davidrothb/ebar/docs/20211007_023445.jpg

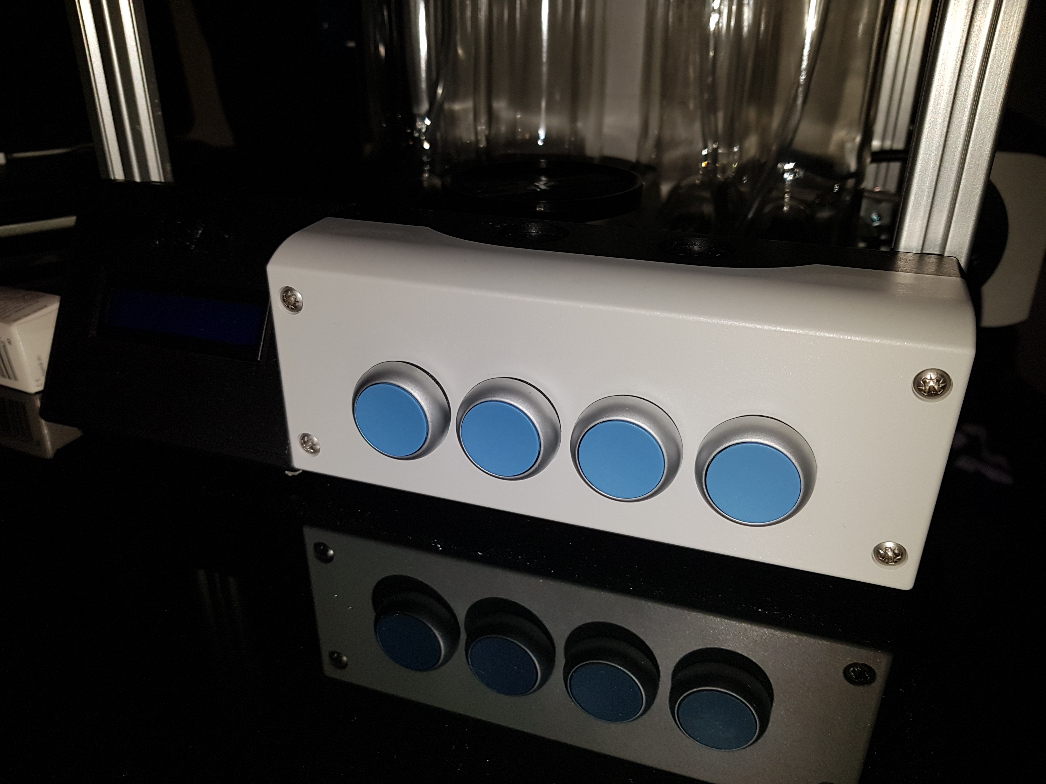
docs/20211007_023445.jpg
