davidrothb/ebar/docs/20210610_223108.jpg

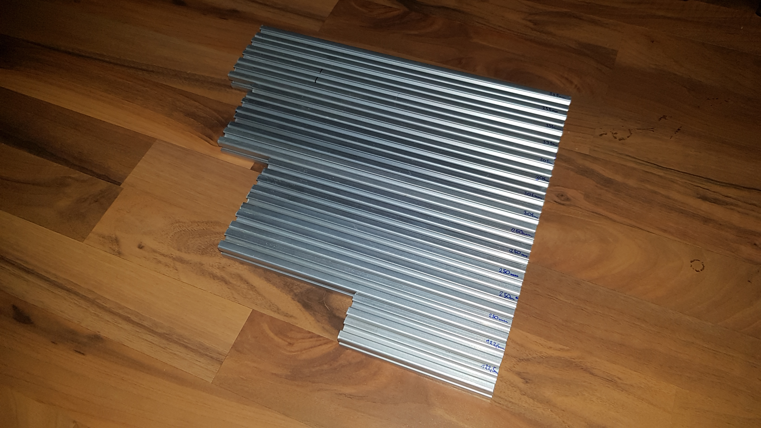
docs/20210610_223108.jpg
