davidrothb/ebar/docs/20210904_211101.jpg

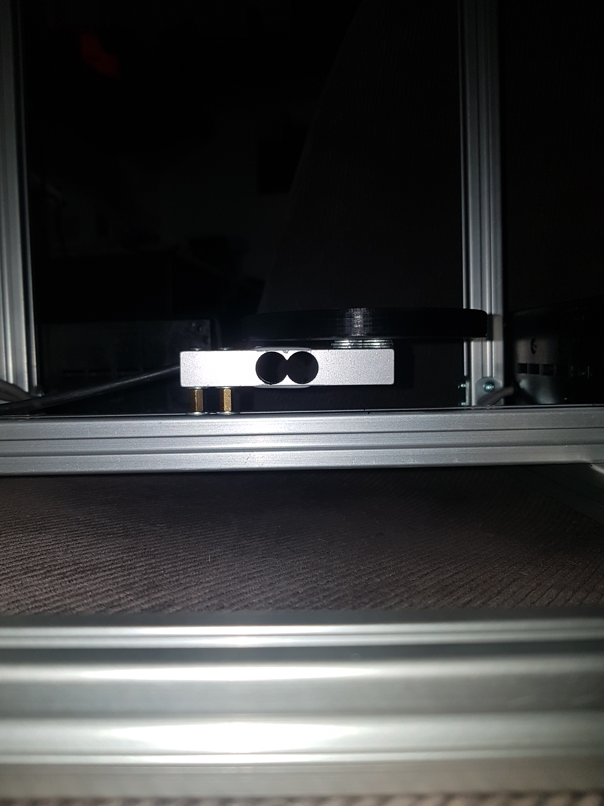
docs/20210904_211101.jpg
