davidrothb/ebar/docs/20210916_174710.jpg

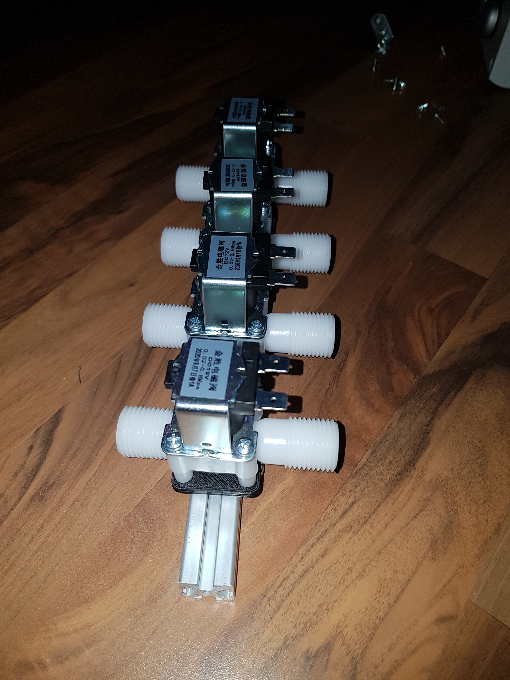
docs/20210916_174710.jpg
