davidrothb/ebar/docs/20210920_230038.jpg

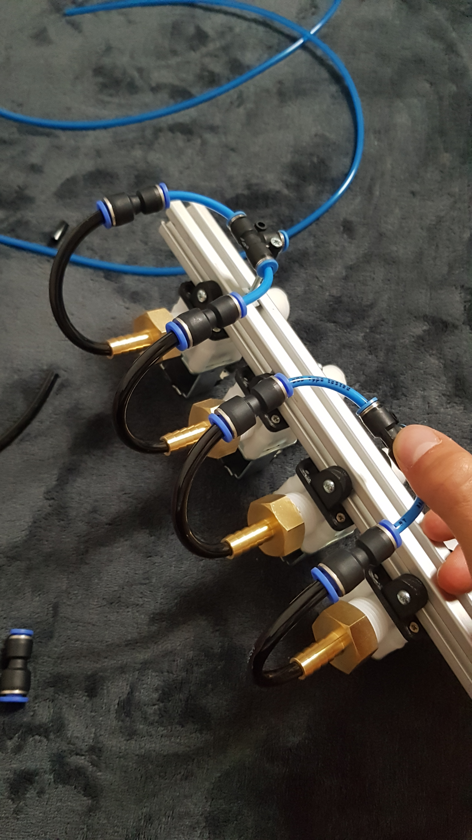
docs/20210920_230038.jpg
