davidrothb/ebar/docs/20210921_202324.jpg

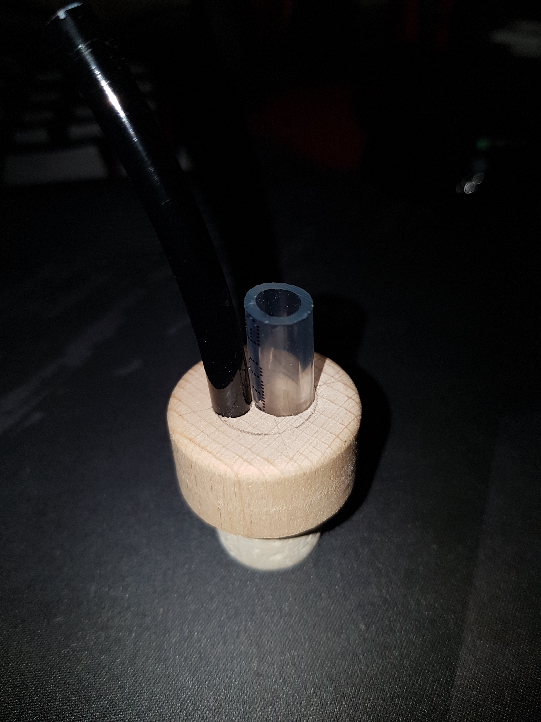
docs/20210921_202324.jpg
