davidrothb/ebar/docs/20210921_202337.jpg

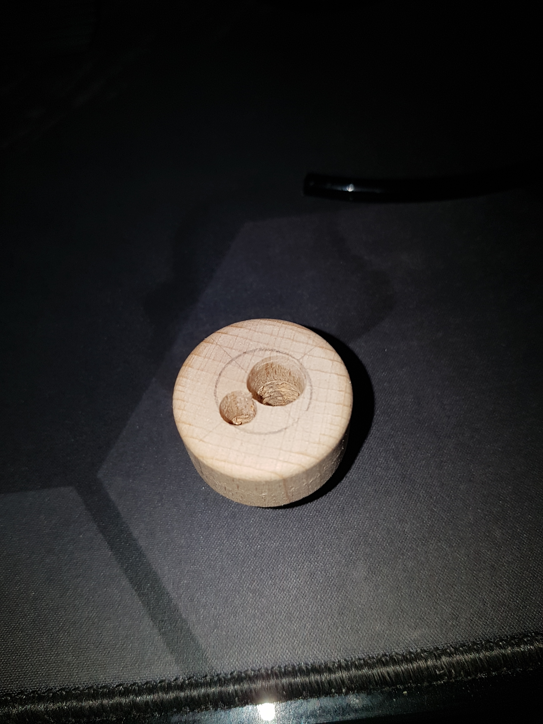
docs/20210921_202337.jpg
