davidrothb/ebar/docs/20210921_204439.jpg

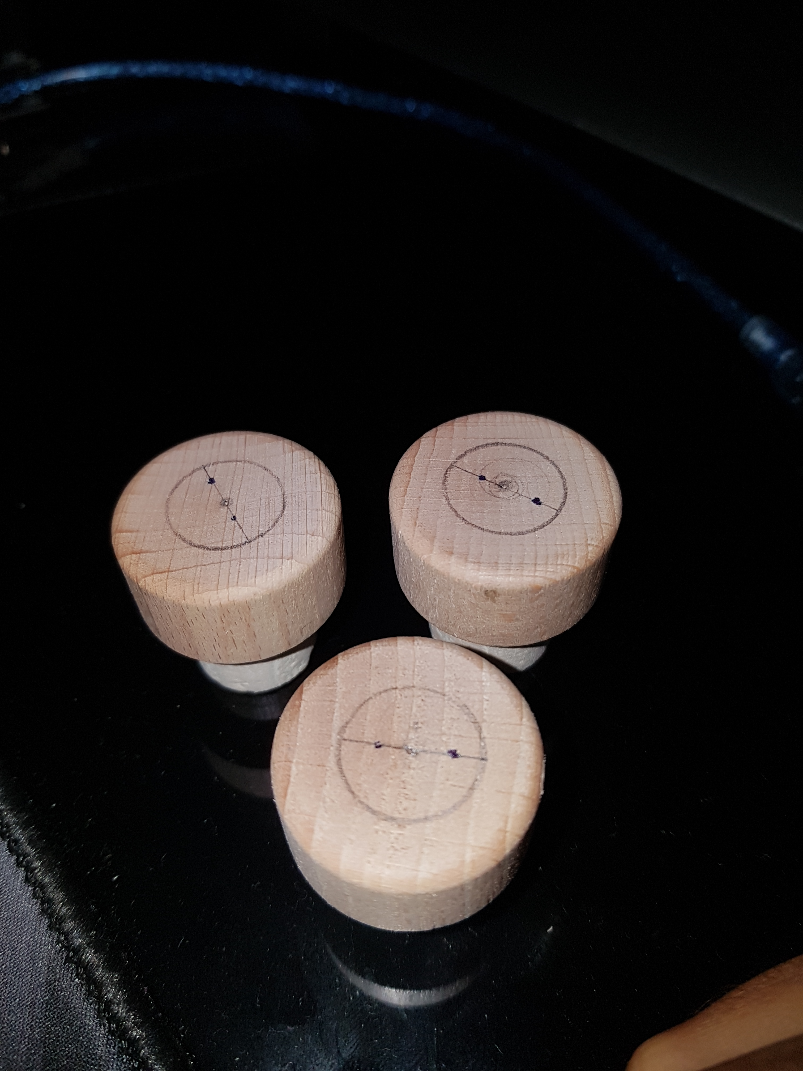
docs/20210921_204439.jpg
