davidrothb/ebar/docs/20210922_183712.jpg

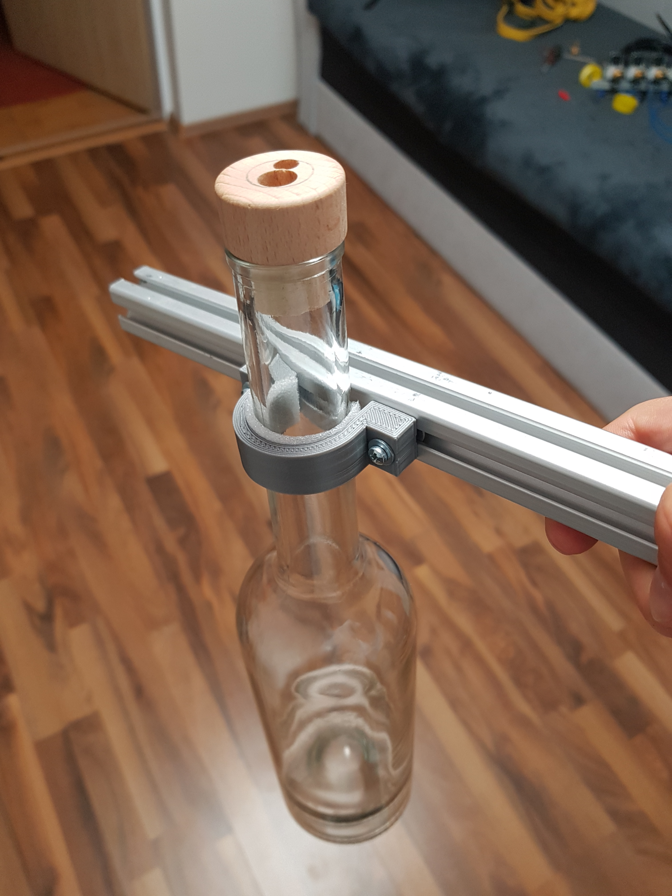
docs/20210922_183712.jpg
