davidrothb/ebar/docs/20210925_224214.jpg

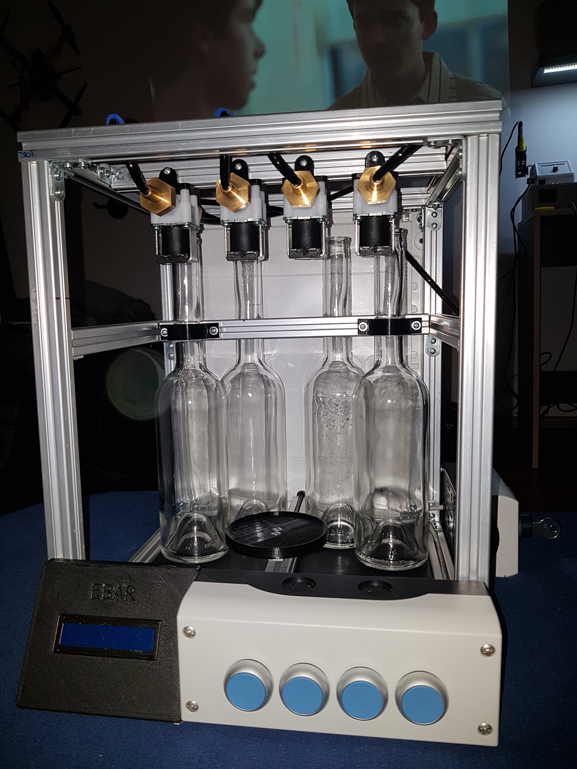
docs/20210925_224214.jpg
