davidrothb/ebar/docs/20210926_215040.jpg

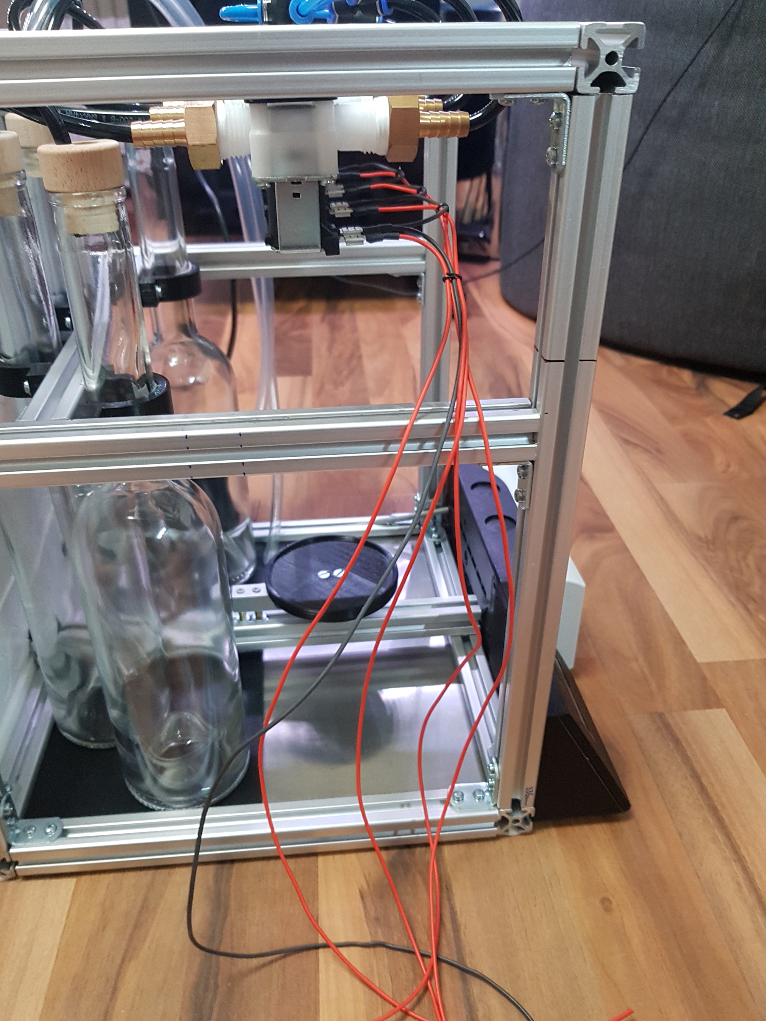
docs/20210926_215040.jpg
