davidrothb/ebar/docs/20210926_222534.jpg

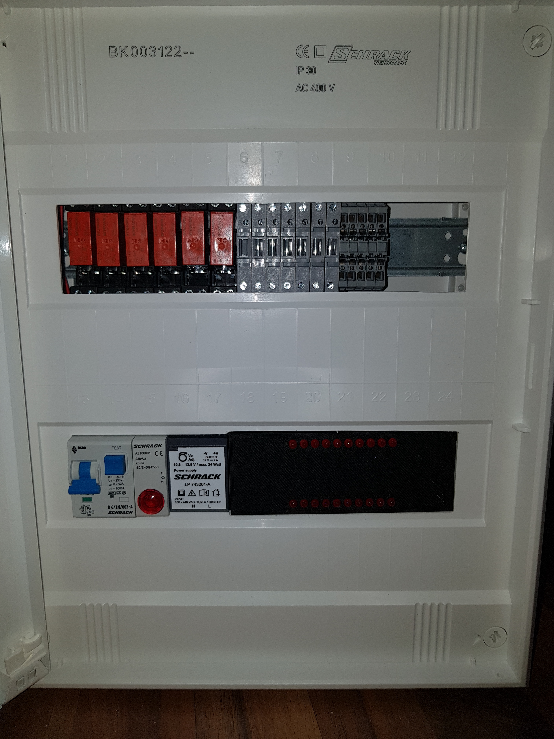
docs/20210926_222534.jpg
