davidrothb/ebar/docs/243801039_290241262632714_5640302074509771731_n.jpg

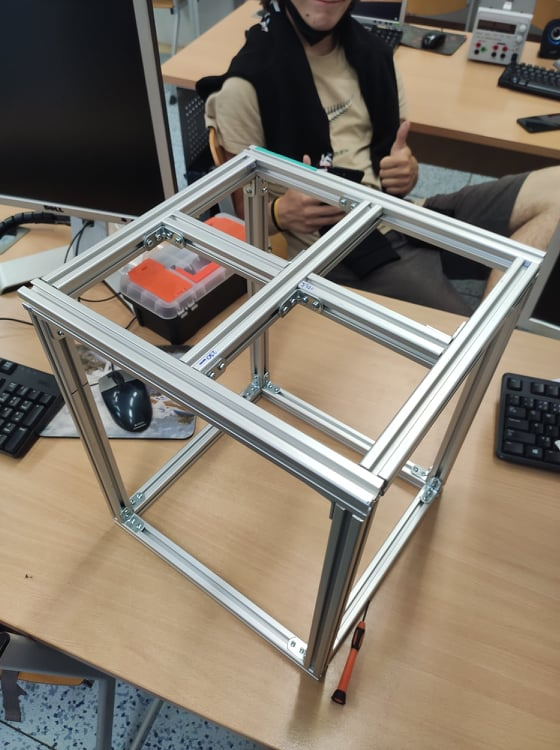
docs/243801039_290241262632714_5640302074509771731_n.jpg
