davidrothb/ebar/docs/webserial_scr.png

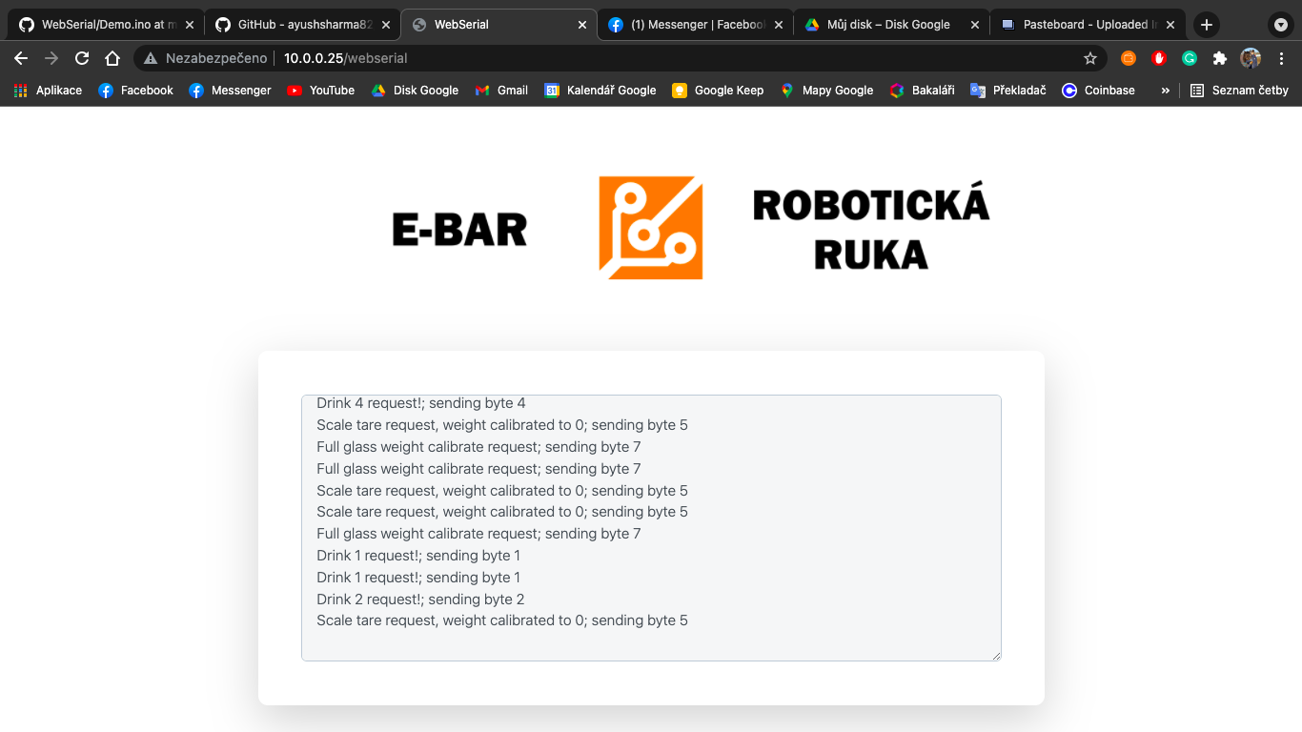
docs/webserial_scr.png
