davidrothb/ebar/ebar/lcd.ino

byte LT[8] =
{
  B00111,
  B01111,
  B11111,
  B11111,
  B11111,
  B11111,
  B11111,
  B11111
};
byte UB[8] =
{
  B11111,
  B11111,
  B11111,
  B00000,
  B00000,
  B00000,
  B00000,
  B00000
};
byte RT[8] =
{
  B11100,
  B11110,
  B11111,
  B11111,
  B11111,
  B11111,
  B11111,
  B11111
};
byte LL[8] =
{
  B11111,
  B11111,
  B11111,
  B11111,
  B11111,
  B11111,
  B01111,
  B00111
};
byte LB[8] =
{
  B00000,
  B00000,
  B00000,
  B00000,
  B00000,
  B11111,
  B11111,
  B11111
};
byte LR[8] =
{
  B11111,
  B11111,
  B11111,
  B11111,
  B11111,
  B11111,
  B11110,
  B11100
};
byte UMB[8] =
{
  B11111,
  B11111,
  B11111,
  B00000,
  B00000,
  B00000,
  B11111,
  B11111
};
byte LMB[8] =
{
  B11111,
  B00000,
  B00000,
  B00000,
  B00000,
  B11111,
  B11111,
  B11111
};

void initLCD() {
  lcd.init();
  lcd.backlight();
  lcd.createChar(8, LT);
  lcd.createChar(1, UB);
  lcd.createChar(2, RT);
  lcd.createChar(3, LL);
  lcd.createChar(4, LB);
  lcd.createChar(5, LR);
  lcd.createChar(6, UMB);
  lcd.createChar(7, LMB);
}

void customA(int x)
{
  lcd.setCursor(x, 0);
  lcd.write(8);
  lcd.write(6);
  lcd.write(2);
  lcd.setCursor(x, 1);
  lcd.write(255);
  lcd.write(254);
  lcd.write(255);
}

void customB(int x)
{
  lcd.setCursor(x, 0);
  lcd.write(255);
  lcd.write(6);
  lcd.write(5);
  lcd.setCursor(x, 1);
  lcd.write(255);
  lcd.write(7);
  lcd.write(2);
}

void customE(int x)
{
  lcd.setCursor(x, 0);
  lcd.write(255);
  lcd.write(6);
  lcd.write(6);
  lcd.setCursor(x, 1);
  lcd.write(255);
  lcd.write(7);
  lcd.write(7);
}

void customR(int x)
{
  lcd.setCursor(x, 0);
  lcd.write(255);
  lcd.write(6);
  lcd.write(2);
  lcd.setCursor(x, 1);
  lcd.write(255);
  lcd.write(254);
  lcd.write(2);
}
