davidrothb/ebar/docs/20210615_203852.jpg

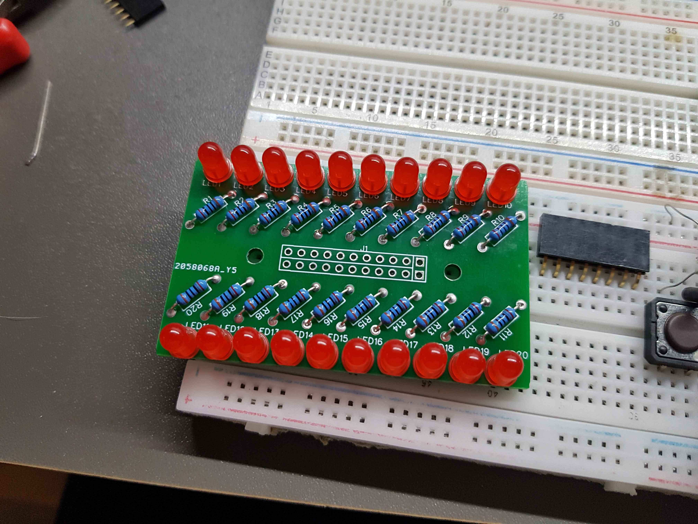
docs/20210615_203852.jpg
