davidrothb/ebar/docs/20210621_213708.jpg

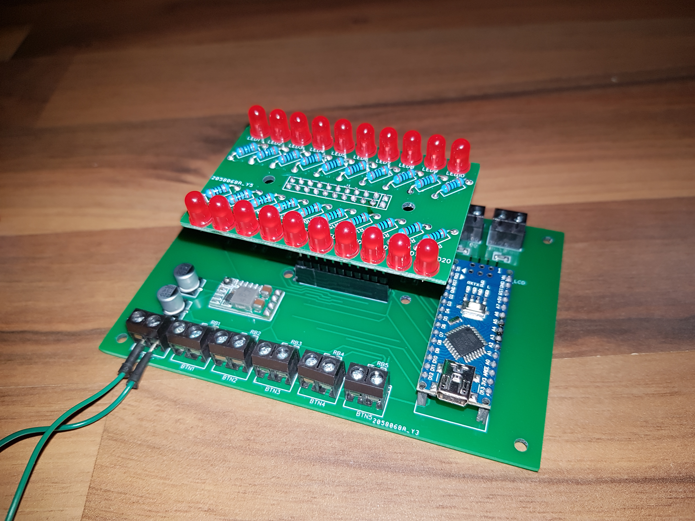
docs/20210621_213708.jpg
