davidrothb/ebar/docs/20210916_153055.jpg

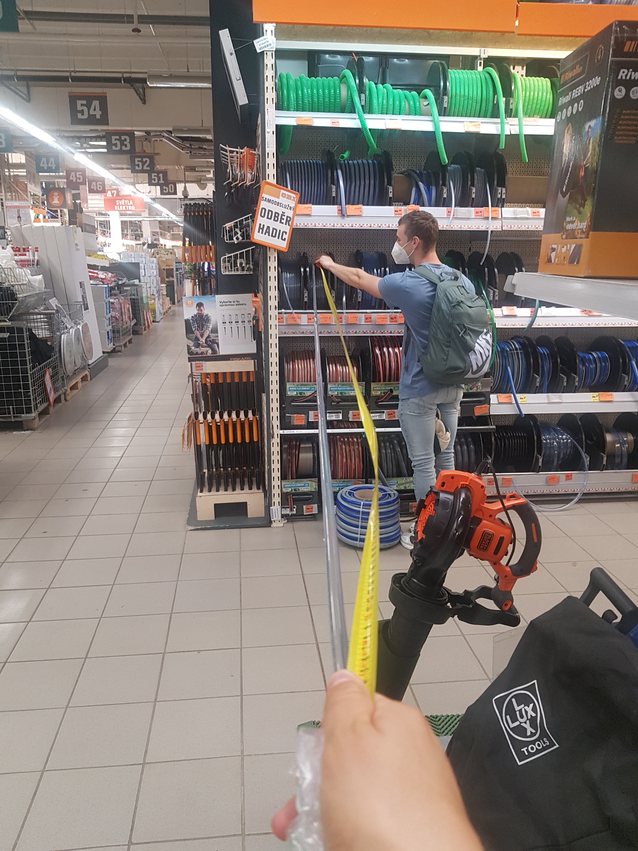
docs/20210916_153055.jpg
