davidrothb/ebar/docs/20211002_224127.jpg

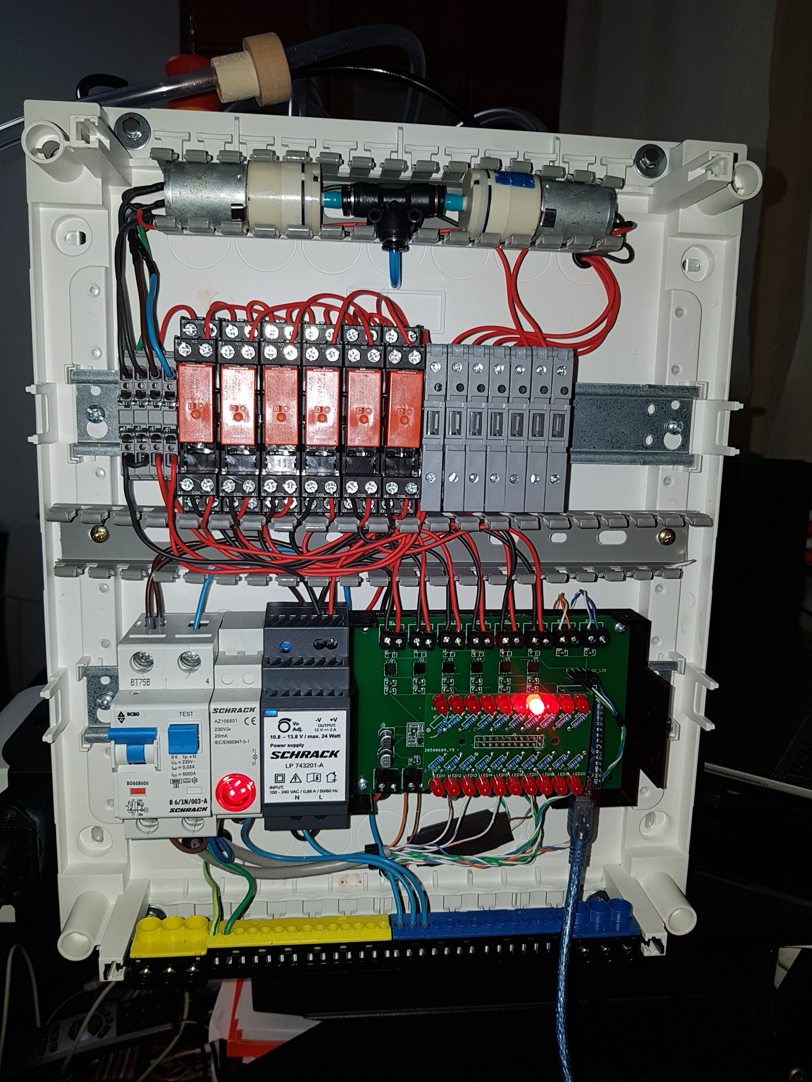
docs/20211002_224127.jpg
