davidrothb/ebar/docs/20210926_222317.jpg

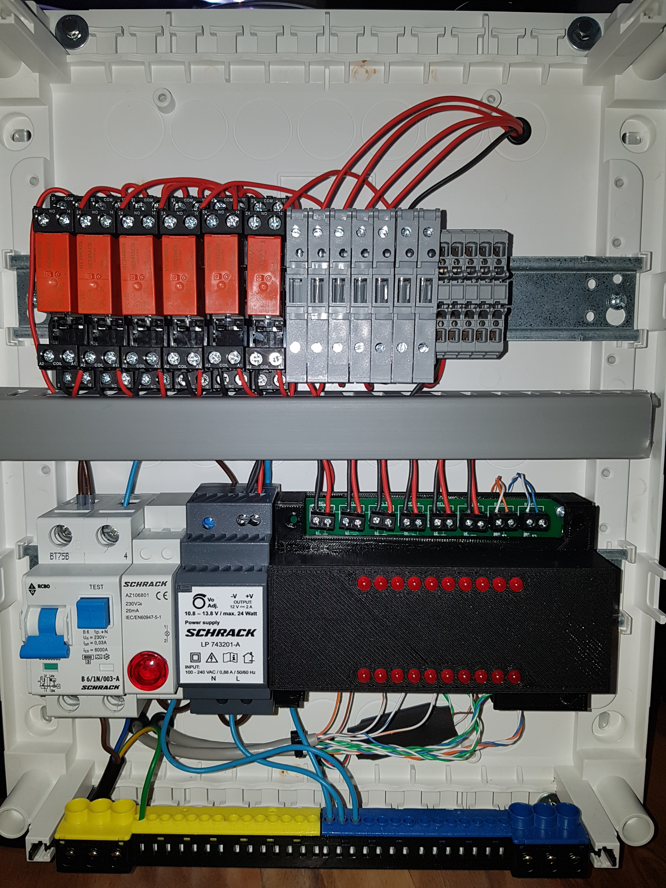
docs/20210926_222317.jpg
